Skycode22/goldfish/cad/goldfish.kicad_pcb

## KiCad design cad/goldfish.kicad_pcb (2022-05-24)

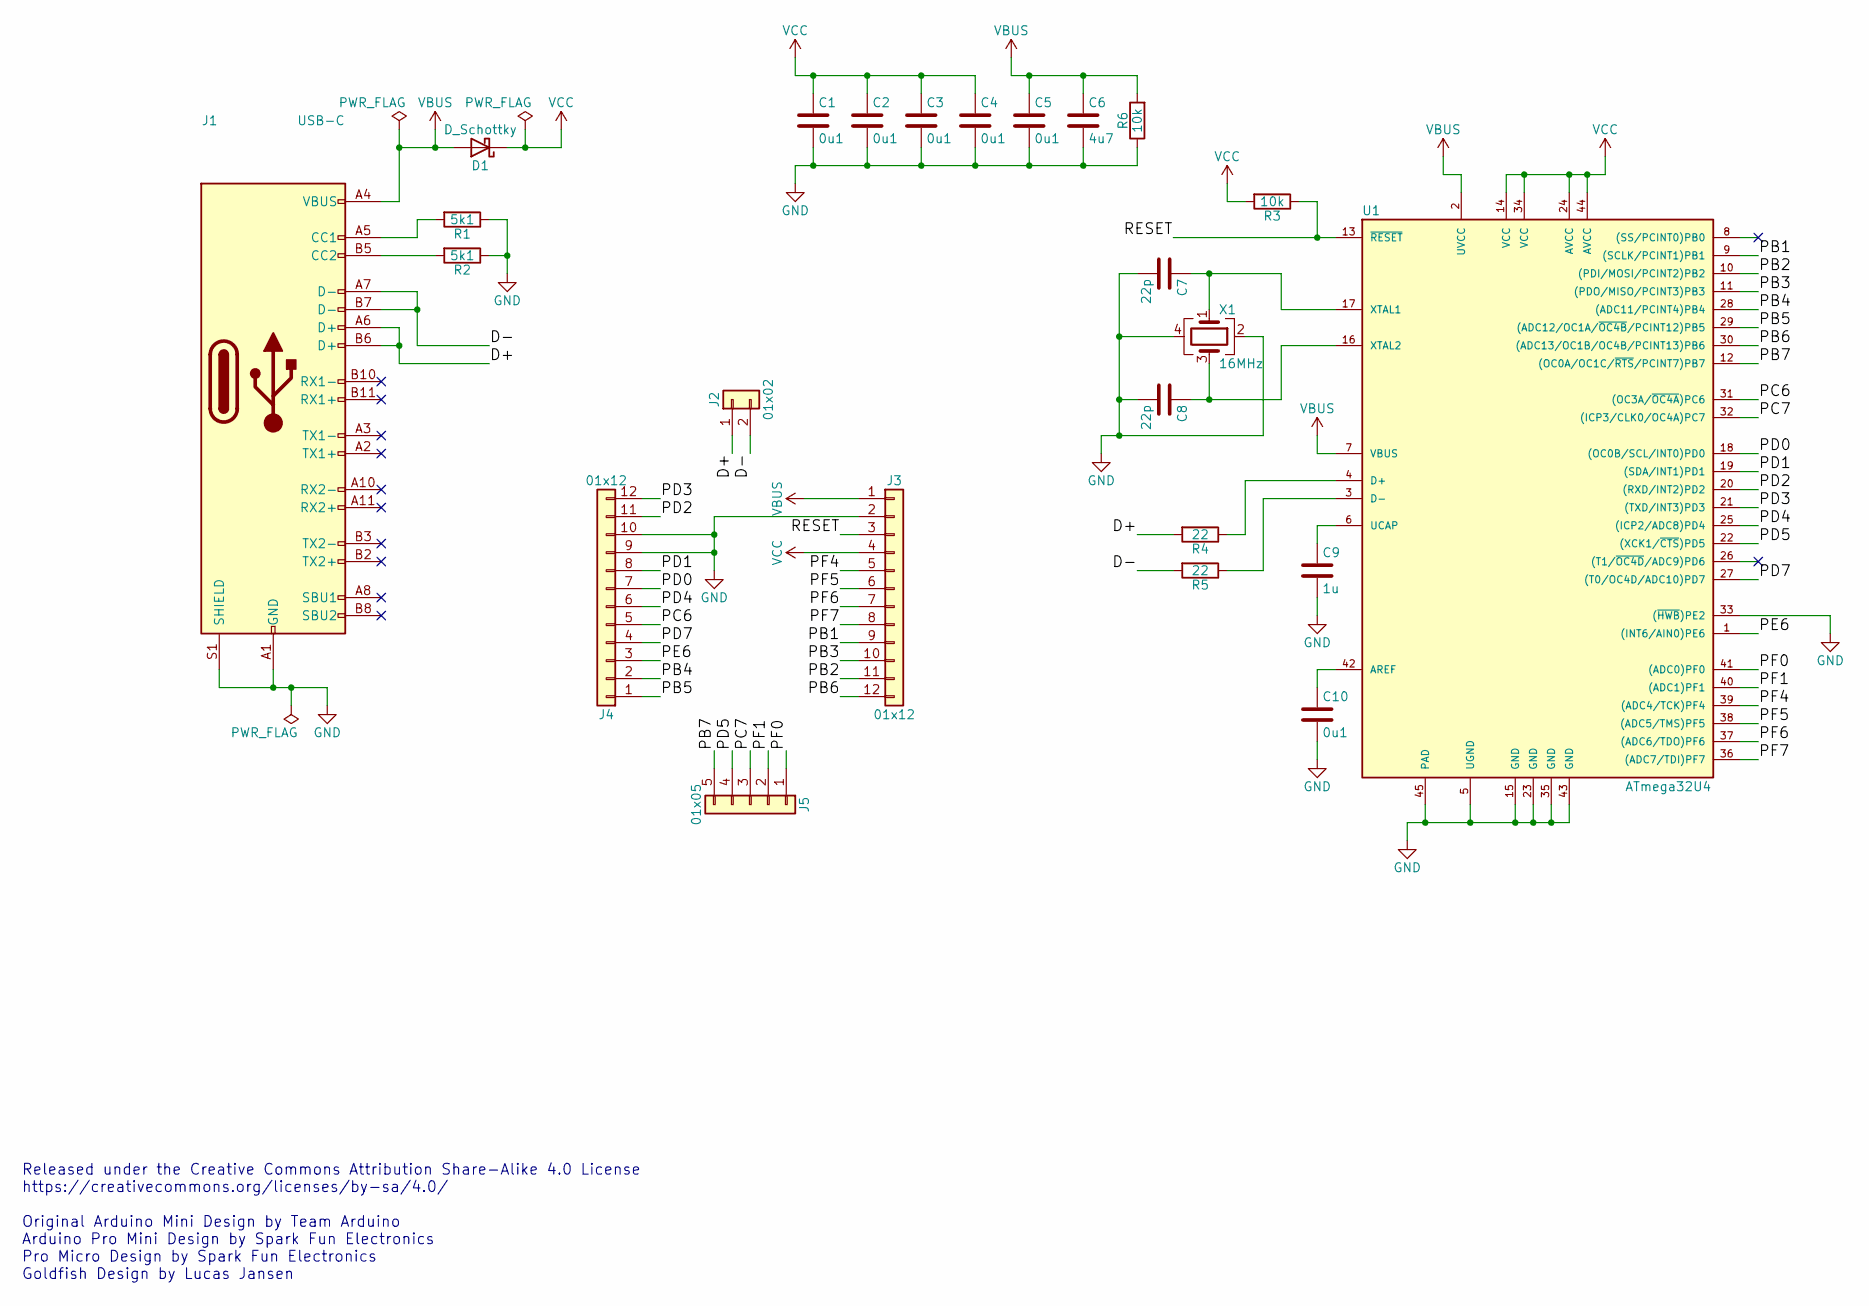
[picture p1: schematic goldfish.kicad_sch]

Parts:
C1, C2, C3, C4, C5, C10: 0u1; C_0402_1005Metric
C6: 4u7; C_0402_1005Metric
C7, C8: 22p; C_0402_1005Metric
C9: 1u; C_0402_1005Metric
D1: D_Schottky; D_PowerDI-123
J1: USB-C; CX70M-24P1
J2: 01x02; Pins2
J3, J4: 01x12; Pins12
J5: 01x05; Pins5
R1, R2: 5k1; R_0402_1005Metric
R3, R6: 10k; R_0402_1005Metric
R4, R5: 22; R_0402_1005Metric
U1: ATmega32U4; QFN-44-1EP_7x7mm_P0.5mm_EP5.2x5.2mm
X1: 16MHz; Crystal_SMD_SeikoEpson_FA238-4Pin_3.2x2.5mm

Connections:
/D+: J1.A6 (D+), J1.B6 (D+), J2.1, R4.2
/D-: J1.A7 (D-), J1.B7 (D-), J2.2, R5.2
/PB1: J3.9, U1.9 ((SCLK/PCINT1)PB1)
/PB2: J3.11, U1.10 ((PDI/MOSI/PCINT2)PB2)
/PB3: J3.10, U1.11 ((PDO/MISO/PCINT3)PB3)
/PB4: J4.2, U1.28 ((ADC11/PCINT4)PB4)
/PB5: J4.1, U1.29 ((ADC12/OC1A/~OC4B/PCINT12)PB5)
/PB6: J3.12, U1.30 ((ADC13/OC1B/OC4B/PCINT13)PB6)
/PB7: J5.5, U1.12 ((OC0A/OC1C/~RTS/PCINT7)PB7)
/PC6: J4.5, U1.31 ((OC3A/~OC4A)PC6)
/PC7: J5.3, U1.32 ((ICP3/CLK0/OC4A)PC7)
/PD0: J4.7, U1.18 ((OC0B/SCL/INT0)PD0)
/PD1: J4.8, U1.19 ((SDA/INT1)PD1)
/PD2: J4.11, U1.20 ((RXD/INT2)PD2)
/PD3: J4.12, U1.21 ((TXD/INT3)PD3)
/PD4: J4.6, U1.25 ((ICP2/ADC8)PD4)
/PD5: J5.4, U1.22 ((XCK1/~CTS)PD5)
/PD7: J4.4, U1.27 ((T0/OC4D/ADC10)PD7)
/PE6: J4.3, U1.1 ((INT6/AIN0)PE6)
/PF0: J5.1, U1.41 ((ADC0)PF0)
/PF1: J5.2, U1.40 ((ADC1)PF1)
/PF4: J3.5, U1.39 ((ADC4/TCK)PF4)
/PF5: J3.6, U1.38 ((ADC5/TMS)PF5)
/PF6: J3.7, U1.37 ((ADC6/TDO)PF6)
/PF7: J3.8, U1.36 ((ADC7/TDI)PF7)
/RESET: J3.3, R3.1, U1.13 (~RESET)
GND: C1.2, C2.2, C3.2, C4.2, C5.2, C6.2, C7.2, C8.2, C9.2, C10.2, J1.A1 (GND), J1.A12 (GND), J1.B1 (GND), J1.B12 (GND), J1.S1 (SHIELD), J3.2, J4.9, J4.10, R1.1, R2.1, R6.1, U1.5 (UGND), U1.15 (GND), U1.23 (GND), U1.33 ((~HWB)PE2), U1.35 (GND), U1.43 (GND), U1.45 (PAD), X1.2, X1.4
unnamed: C7.1, U1.17 (XTAL1), X1.1
unnamed: C8.1, U1.16 (XTAL2), X1.3
unnamed: C9.1, U1.6 (UCAP)
unnamed: C10.1, U1.42 (AREF)
unnamed: J1.A5 (CC1), R1.2
unnamed: J1.B5 (CC2), R2.2
unnamed: R4.1, U1.4 (D+)
unnamed: R5.1, U1.3 (D-)
VBUS: C5.1, C6.1, D1.2 (A), J1.A4 (VBUS), J1.A9 (VBUS), J1.B4 (VBUS), J1.B9 (VBUS), J3.1, R6.2, U1.2 (UVCC), U1.7 (VBUS)
VCC: C1.1, C2.1, C3.1, C4.1, D1.1 (K), J3.4, R3.2, U1.14 (VCC), U1.24 (AVCC), U1.34 (VCC), U1.44 (AVCC)

Notes on the sheet:
Released under the Creative Commons Attribution Share-Alike 4.0 License https://creativecommons.org/licenses/by-sa/4.0/ Original Arduino Mini Design by Team Arduino Arduino Pro Mini Design by Spark Fun Electronics Pro Micro Design by Spark Fun Electronics Goldfish Design by Lucas Jansen

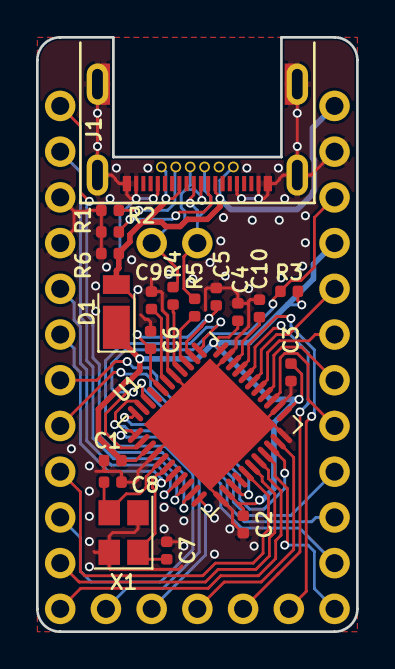
[picture p2: board goldfish.kicad_pcb from above]

Board: 2 copper layers, 17.8 x 33.0 mm, 24 parts (0 on the bottom side), 37 nets.
